strobo/u-battery/hardware/IMG_20130329_181824.jpg

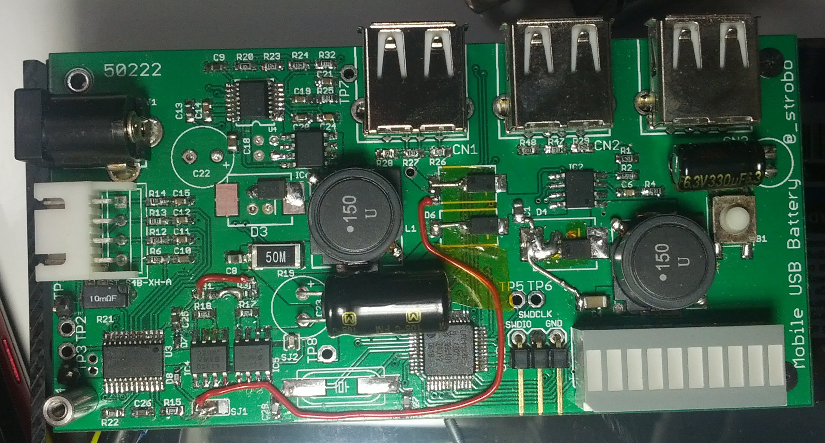
hardware/IMG_20130329_181824.jpg
