strobo/u-battery/hardware/assembly-guide.JPG

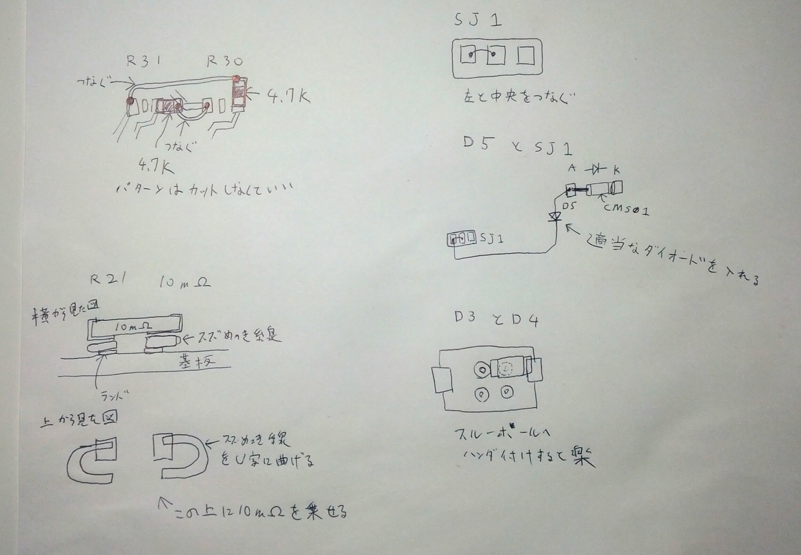
hardware/assembly-guide.JPG
