strobo/u-battery/README.md

u-Battery
===========

What's this?
------------
This is Mobile USB battery Unit.

This repo includes eagle .sch/.brd file and cortex-m0 source code.
