strobo/u-battery/hardware/brd.png

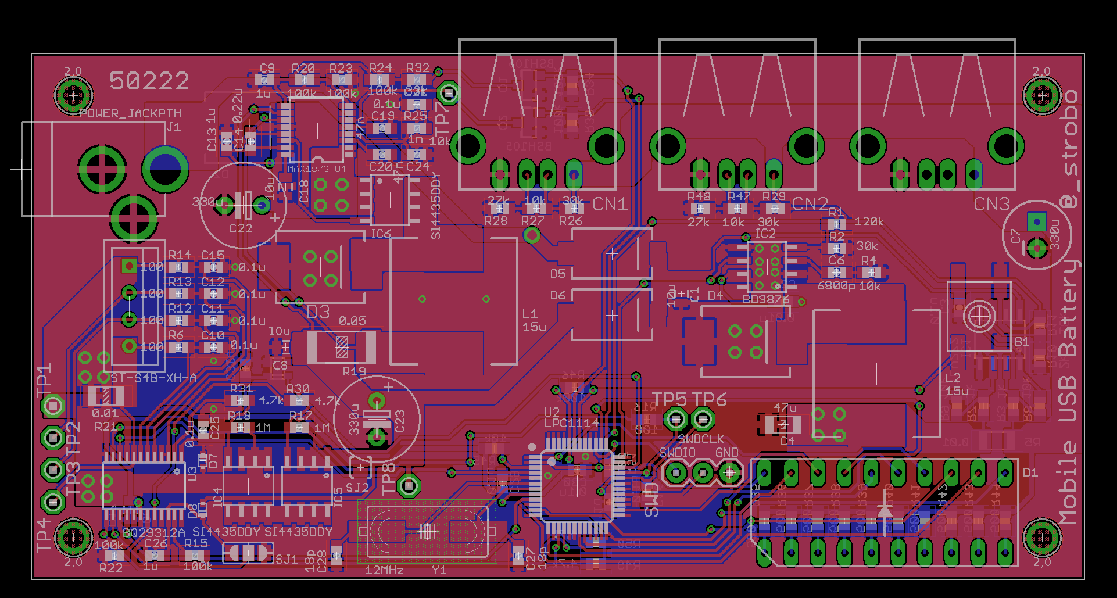
hardware/brd.png
