strobo/u-battery/hardware/brd_btn.png

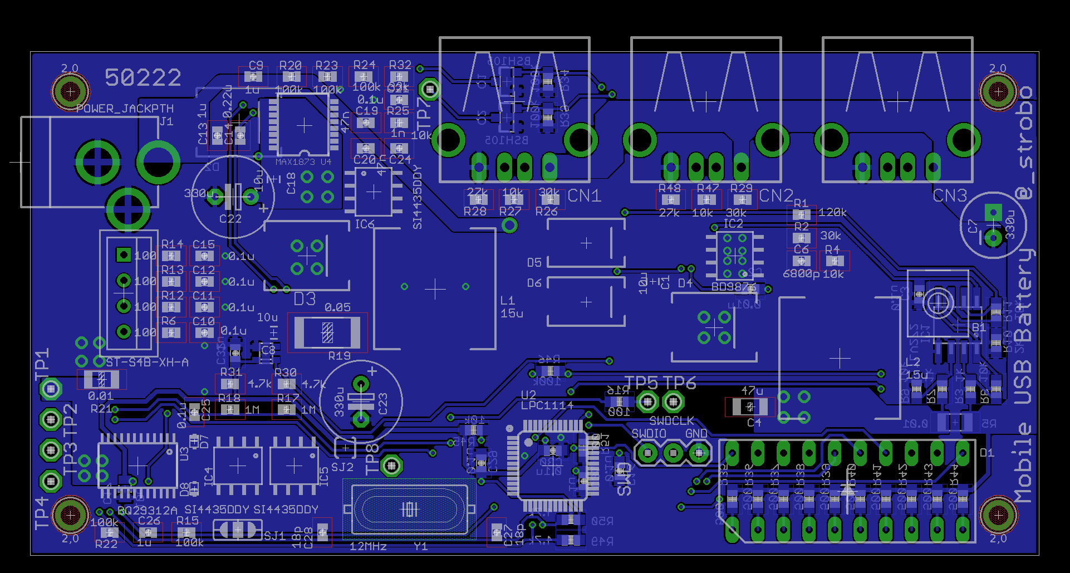
hardware/brd_btn.png
