strobo/u-battery/hardware/brd_t.png

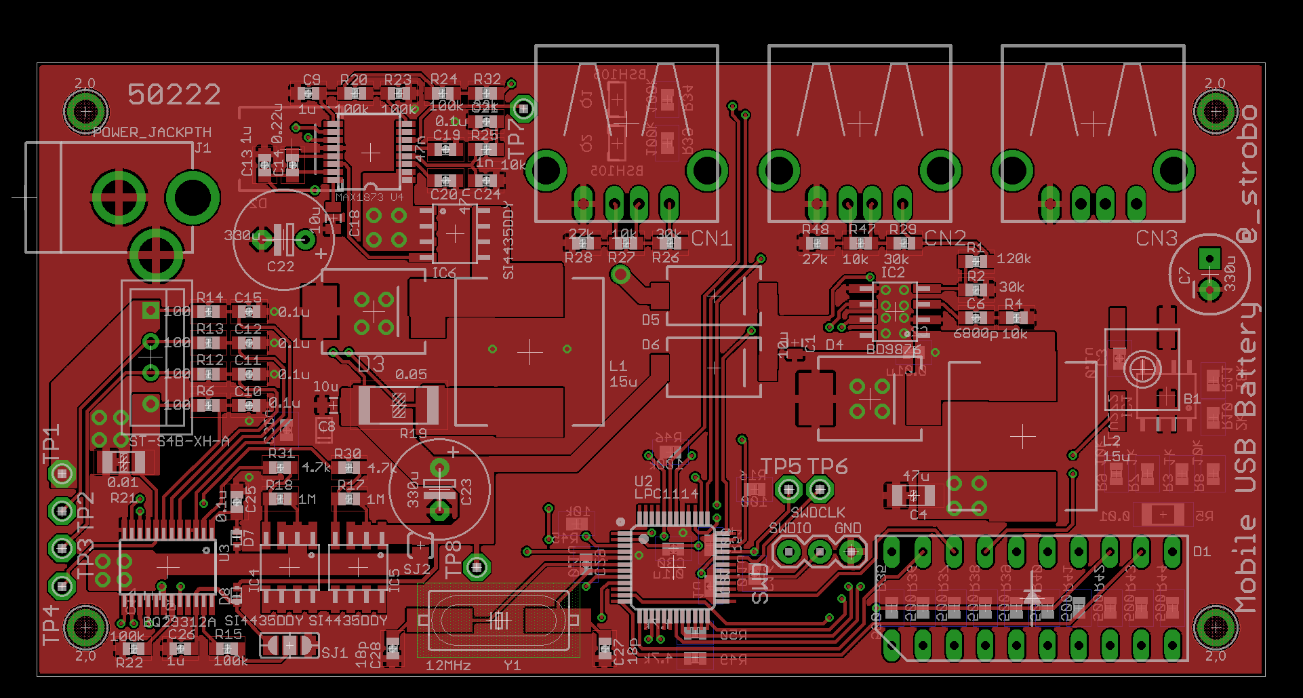
hardware/brd_t.png
