strobo/u-battery/hardware/IMG_20130329_230819.jpg

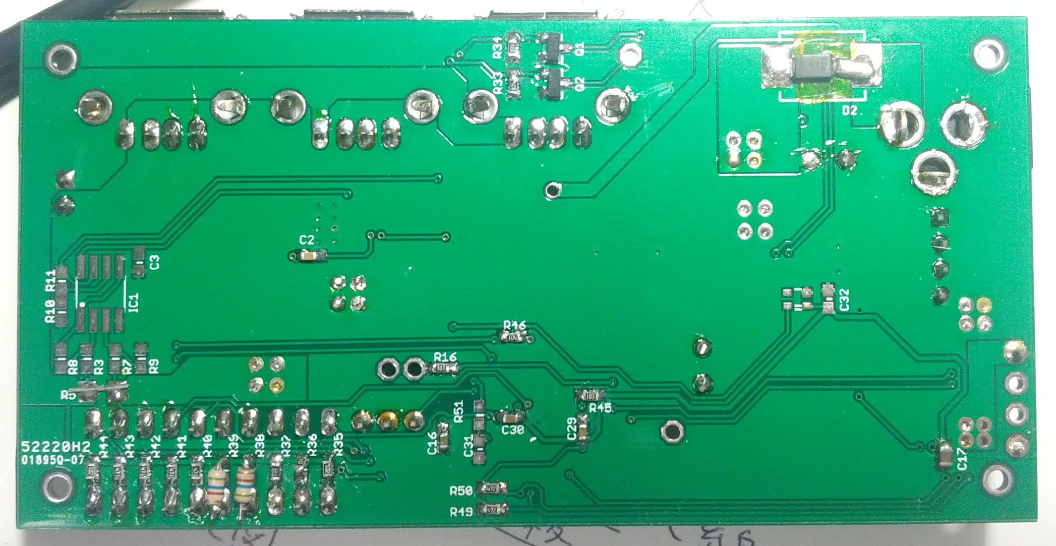
hardware/IMG_20130329_230819.jpg
