strobo/u-battery/hardware/sch.png

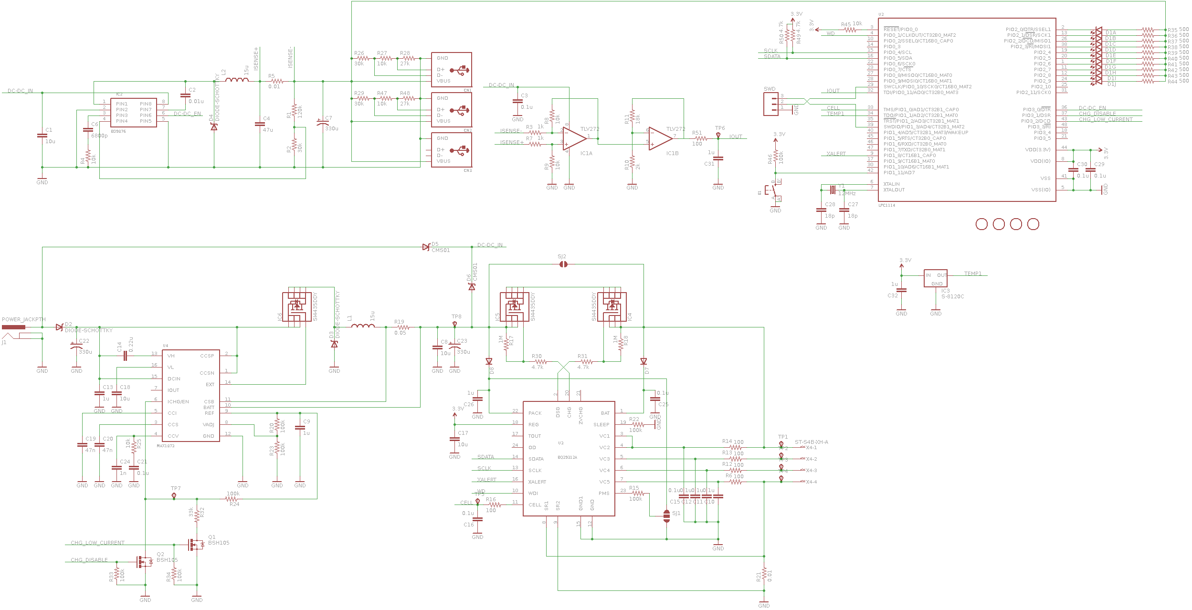
hardware/sch.png
