strobo/u-battery/hardware/mobileCharger.brd

## EAGLE design hardware/mobileCharger.brd (2012-09-06)

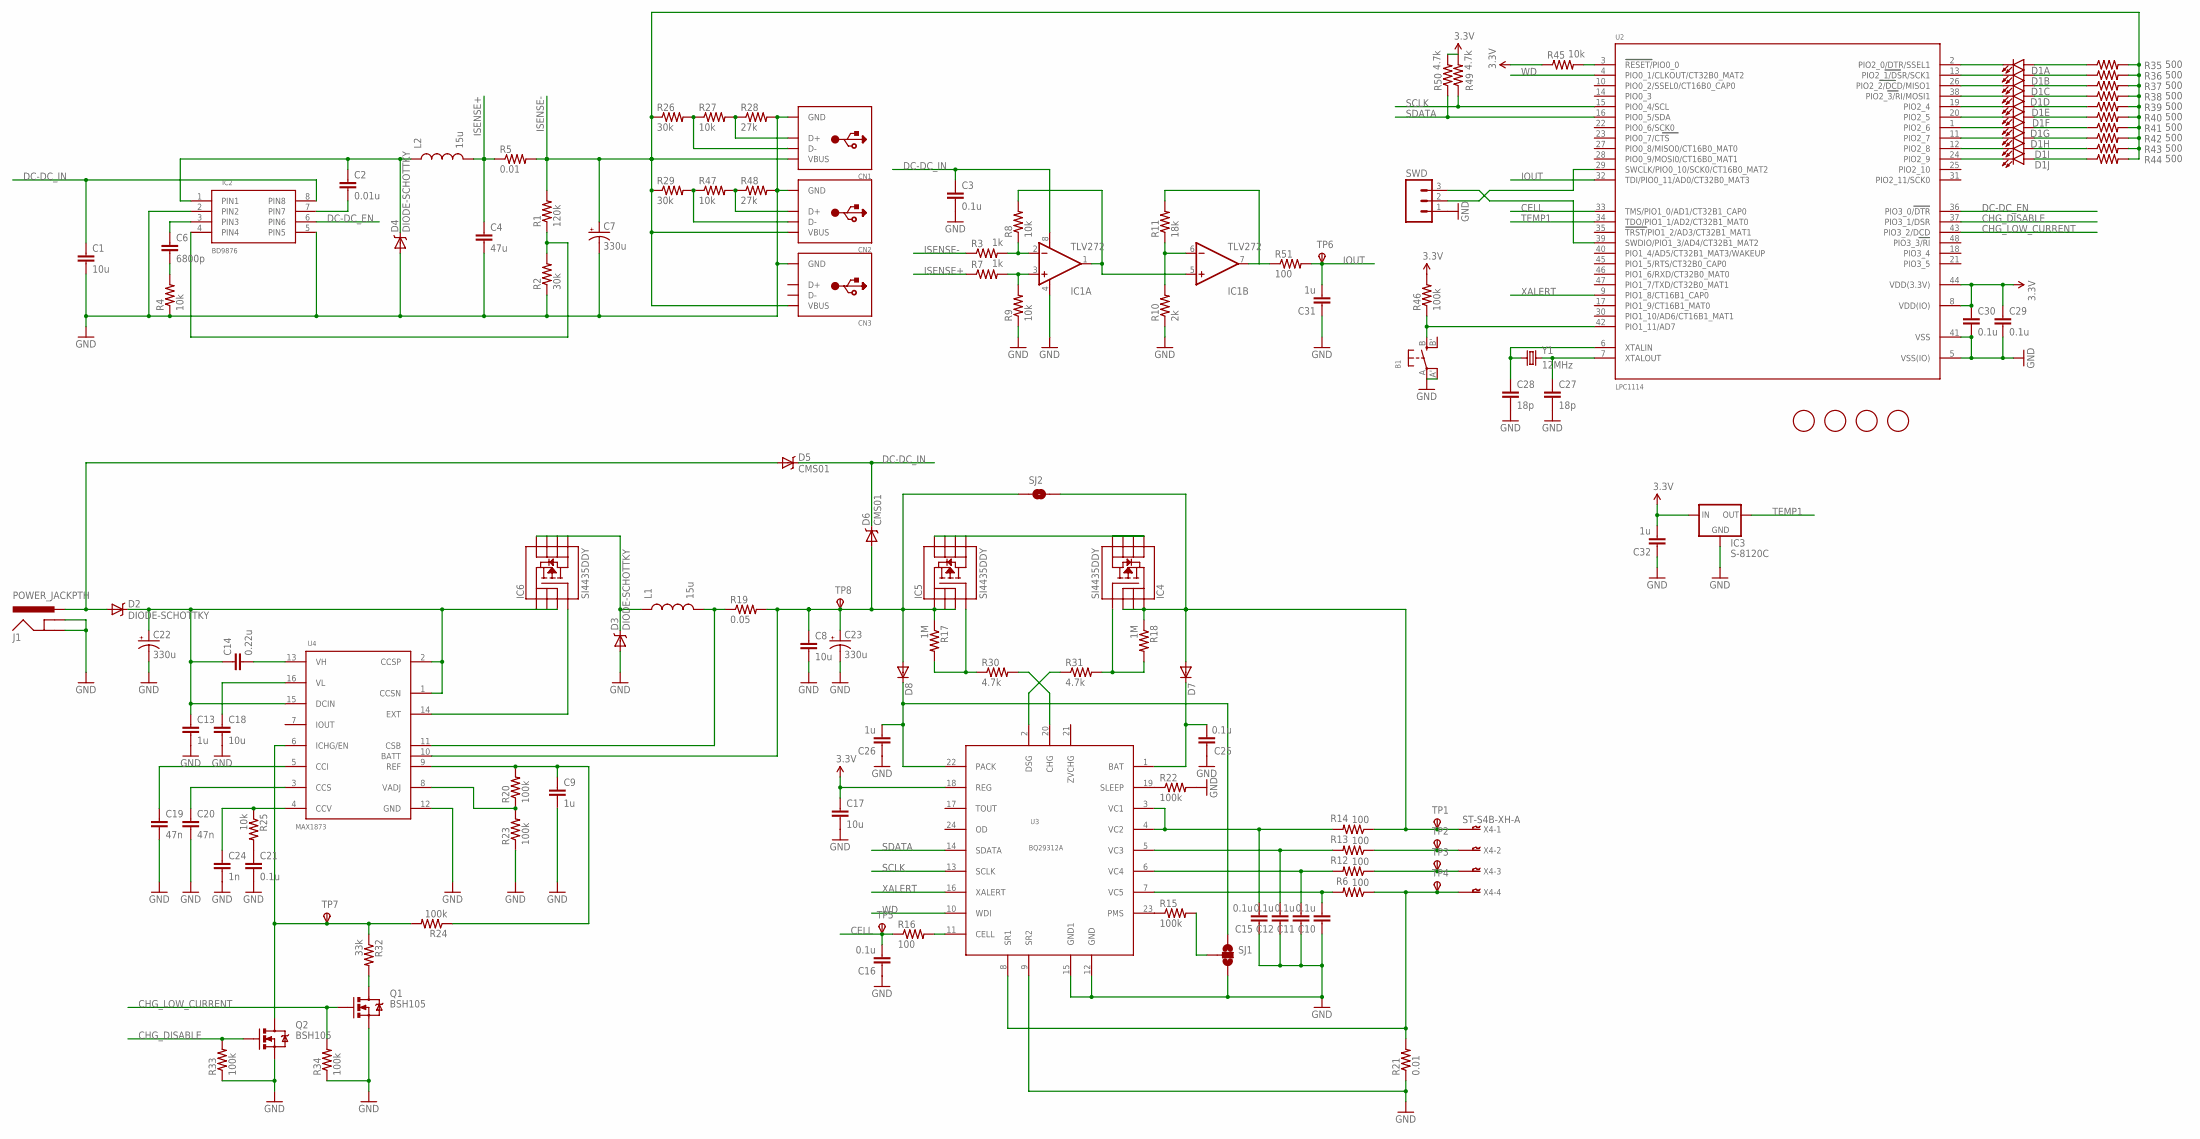
[picture p8: schematic mobileCharger.sch]

Parts:
B1: SWITCH_TACT_SMT; EVQ-Q2
C1, C8, C17, C18: 10u; 0805
C2: 0.01u; 0603-CAP
C3, C10, C11, C12, C15, C16, C21, C25, C29, C30: 0.1u; 0603-CAP
C4: 47u; 1206
C6: 6800p; 0603-CAP
C7: 330u; CPOL-RADIAL-100UF-25V
C9, C13, C26, C31, C32: 1u; 0603-CAP
C14: 0.22u; 0603-CAP
C19, C20: 47n; 0603-CAP
C22, C23: 330u; E3,5-8
C24: 1n; 0603-CAP
C27, C28: 18p; 0603-CAP
CN1, CN2, CN3: USB_TYPEAPTHFML; USB_HOST-PTH
D1: LED_BARGRAPH_10; LED_BARGAPH_10
D2, D3, D4: DIODE-SCHOTTKY; SOD-128
D5, D6: CMS01; M-FLAT
D7, D8: DIODESOD523; SOD523
IC1: TLV272; SO08
IC2: BD9876; SO08
IC3: S-8120C; SC-82AB
IC4, IC5, IC6: SI4435DDY; SO08
J1: POWER_JACKPTH; POWER_JACK_PTH
L1, L2: 15u; CDRH125
Q1, Q2: BSH105; SOT23-3
R1: 120k; 0603-RES
R2, R26, R29: 30k; 0603-RES
R3, R7: 1k; 0603-RES
R4, R8, R9, R25, R27, R45, R47: 10k; 0603-RES
R5, R21: 0.01; R1206
R6, R12, R13, R14, R16, R51: 100; 0603-RES
R10: 2k; 0603-RES
R11: 18k; 0603-RES
R15, R20, R22, R23, R24, R33, R34, R46: 100k; 0603-RES
R17, R18: 1M; 0603-RES
R19: 0.05; R2512
R28, R48: 27k; 0603-RES
R30, R31, R49, R50: 4.7k; 0603-RES
R32: 33k; 0603-RES
R35, R36, R37, R38, R39, R40, R41, R42, R43, R44: 500; 0603-RES
SJ1: SOLDERJUMPER_2WAYT; SJ_2
SJ2: SOLDERJUMPERNO; SJ_2S-NO
SWD: M03PTH; 1X03
TP1, TP2, TP3, TP4, TP5, TP6, TP7, TP8: TPSPAD1-13; P1-13
U2: LPC1114; LQFP48
U3: BQ29312A; TSSOP-24
U4: MAX1873; TSSOP16
U$1, U$2, U$3, U$7: MOUNTINGHOLE2.0; MOUNTINGHOLE_2.0_PLATED
X4: ST-S4B-XH-A; B4B-XH
Y1: 12MHz; HC49UP

Connections:
3.3V: C17.1, C29.1, C30.1, C32.2, IC3.P$1 (IN), R45.1, R46.2, R49.2, R50.2, U2.8 (VDD(IO)), U2.44 (VDD(3.3V)), U3.18 (REG)
CELL: C16.2, R16.1, TP5.TP, U2.33 (TMS/PIO1_0/AD1/CT32B1_CAP0)
CHG_DISABLE: Q2.1 (G), R33.2, U2.37 (PIO3_1/DSR)
CHG_LOW_CURRENT: Q1.1 (G), R34.2, U2.43 (PIO3_2/DCD)
DC-DC_EN: IC2.6 (PIN6), U2.36 (PIO3_0/DTR)
DC-DC_IN: C1.1, C3.1, D5.P$2 (C), D6.P$2 (C), IC1.8 (V+), IC2.8 (PIN8)
GND: B1.A, B1.A' (P1), C1.2, C3.2, C4.2, C7.2 (-), C8.2, C9.2, C10.1, C11.1, C12.1, C13.2, C15.1, C16.1, C17.2, C18.2, C19.2, C20.2, C21.2, C22.-, C23.-, C24.2, C25.1, C26.1, C27.2, C28.2, C29.2, C30.2, C31.1, C32.1, CN1.GND, CN2.GND, CN3.GND, D3.P$1 (A), D4.P$1 (A), IC1.4 (V-), IC2.2 (PIN2), IC2.5 (PIN5), IC3.P$2 (GND), J1.GND, J1.GNDBREAK, Q1.2 (S), Q2.2 (S), R2.1, R4.1, R9.1, R10.1, R21.1, R22.2, R23.1, R28.2, R33.1, R34.1, R48.2, SJ1.3, SWD.1, U2.5 (VSS(IO)), U2.41 (VSS), U3.9 (SR2), U3.12 (GND), U3.15 (GND1), U4.12 (GND)
IOUT: C31.2, R51.2, TP6.TP, U2.32 (TDI/PIO0_11/AD0/CT32B0_MAT3)
ISENSE+: C4.1, L2.2, R5.1, R7.1
ISENSE-: C7.1 (+), CN1.VBUS, CN2.VBUS, CN3.VBUS, R1.2, R3.1, R5.2, R26.1, R29.1, R35.2, R36.2, R37.2, R38.2, R39.2, R40.2, R41.2, R42.2, R43.2, R44.2
unnamed: C2.2, IC2.7 (PIN7)
unnamed: IC1.2 (-IN), R3.2, R8.1
unnamed: IC1.3 (+IN), R7.2, R9.2
unnamed: D1.1 (A), R35.1
unnamed: C2.1, D4.P$2 (C), IC2.1 (PIN1), L2.1
unnamed: IC1.6 (-IN), R10.2, R11.1
unnamed: C6.2, R4.2
unnamed: IC1.1 (OUT), IC1.5 (+IN), R8.2
unnamed: IC2.4 (PIN4), R1.1, R2.2
unnamed: C6.1, IC2.3 (PIN3)
unnamed: C9.1, R20.2, R24.1, U4.9 (REF)
unnamed: R15.2, SJ1.2
unnamed: C15.2, R14.2, U3.3 (VC1), U3.4 (VC2)
unnamed: D7.A, IC4.1 (S), IC4.2 (S), IC4.3 (S), R14.1, R18.1, SJ2.2, TP1.TP, X4.P$1
unnamed: R15.1, U3.23 (PMS)
unnamed: R16.2, U3.11 (CELL)
unnamed: C10.2, R6.2, U3.7 (VC5)
unnamed: IC4.5 (D), IC4.6 (D), IC4.7 (D), IC4.8 (D), IC5.5 (D), IC5.6 (D), IC5.7 (D), IC5.8 (D)
unnamed: C12.2, R13.2, U3.5 (VC3)
unnamed: C11.2, R12.2, U3.6 (VC4)
unnamed: R22.1, U3.19 (SLEEP)
unnamed: IC5.4 (G), R17.2, R30.1
unnamed: C26.2, D8.C, SJ1.1, U3.22 (PACK)
unnamed: IC4.4 (G), R18.2, R31.2
unnamed: C8.1, C23.+, D6.P$1 (A), D8.A, IC5.1 (S), IC5.2 (S), IC5.3 (S), R17.1, R19.2, SJ2.1, TP8.TP, U4.10 (BATT)
unnamed: R6.1, R21.2, TP4.TP, U3.8 (SR1), X4.P$4
unnamed: R20.1, R23.2, U4.8 (VADJ)
unnamed: L1.2, R19.1, U4.11 (CSB)
unnamed: Q1.3 (D), R32.2
unnamed: IC6.4 (G), U4.14 (EXT)
unnamed: Q2.3 (D), R24.2, R32.1, TP7.TP, U4.6 (ICHG/EN)
unnamed: D3.P$2 (C), IC6.5 (D), IC6.6 (D), IC6.7 (D), IC6.8 (D), L1.1
unnamed: C19.1, U4.5 (CCI)
unnamed: C20.1, U4.3 (CCS)
unnamed: C14.2, U4.13 (VH)
unnamed: C18.1, U4.16 (VL)
unnamed: C24.1, R25.1, U4.4 (CCV)
unnamed: C21.1, R25.2
unnamed: D2.P$1 (A), D5.P$1 (A), J1.PWR
unnamed: CN1.D+, R27.2, R28.1
unnamed: C13.1, C14.1, C22.+, D2.P$2 (C), IC6.1 (S), IC6.2 (S), IC6.3 (S), U4.1 (CCSN), U4.2 (CCSP), U4.15 (DCIN)
unnamed: R30.2, U3.20 (CHG)
unnamed: CN1.D-, R26.2, R27.1
unnamed: R31.1, U3.2 (DSG)
unnamed: SWD.2, U2.29 (SWCLK/PIO0_10/SCK0/CT16B0_MAT2)
unnamed: SWD.3, U2.39 (SWDIO/PIO1_3/AD4/CT32B1_MAT2)
unnamed: C25.2, D7.C, U3.1 (BAT)
unnamed: D1.2 (A), R36.1
unnamed: D1.3 (A), R37.1
unnamed: D1.4 (A), R38.1
unnamed: D1.5 (A), R39.1
unnamed: D1.6 (A), R40.1
unnamed: D1.7 (A), R41.1
unnamed: D1.9 (A), R43.1
unnamed: D1.8 (A), R42.1
unnamed: D1.10 (A), R44.1
unnamed: R45.2, U2.3 (RESET/PIO0_0)
unnamed: C28.1, U2.6 (XTALIN), Y1.1
unnamed: C27.1, U2.7 (XTALOUT), Y1.2
unnamed: D1.20 (C), U2.2 (PIO2_0/DTR/SSEL1)
unnamed: D1.19 (C), U2.13 (PIO2_1/DSR/SCK1)
unnamed: D1.18 (C), U2.26 (PIO2_2/DCD/MISO1)
unnamed: D1.17 (C), U2.38 (PIO2_3/RI/MOSI1)
unnamed: D1.16 (C), U2.19 (PIO2_4)
unnamed: D1.15 (C), U2.20 (PIO2_5)
unnamed: D1.14 (C), U2.1 (PIO2_6)
unnamed: D1.13 (C), U2.11 (PIO2_7)
unnamed: D1.12 (C), U2.12 (PIO2_8)
unnamed: D1.11 (C), U2.24 (PIO2_9)
unnamed: B1.B (S), R46.1, U2.42 (PIO1_11/AD7)
unnamed: R13.1, TP2.TP, X4.P$2
unnamed: R12.1, TP3.TP, X4.P$3
unnamed: CN2.D-, R29.2, R47.1
unnamed: CN2.D+, R47.2, R48.1
unnamed: IC1.7 (OUT), R11.2, R51.1
SCLK: R49.1, U2.15 (PIO0_4/SCL), U3.13 (SCLK)
SDATA: R50.1, U2.16 (PIO0_5/SDA), U3.14 (SDATA)
TEMP1: IC3.P$4 (OUT), U2.34 (TDO/PIO1_1/AD2/CT32B1_MAT0)
WD: U2.4 (PIO0_1/CLKOUT/CT32B0_MAT2), U3.10 (WDI)
XALERT: U2.9 (PIO1_8/CT16B1_CAP0), U3.16 (XALERT)

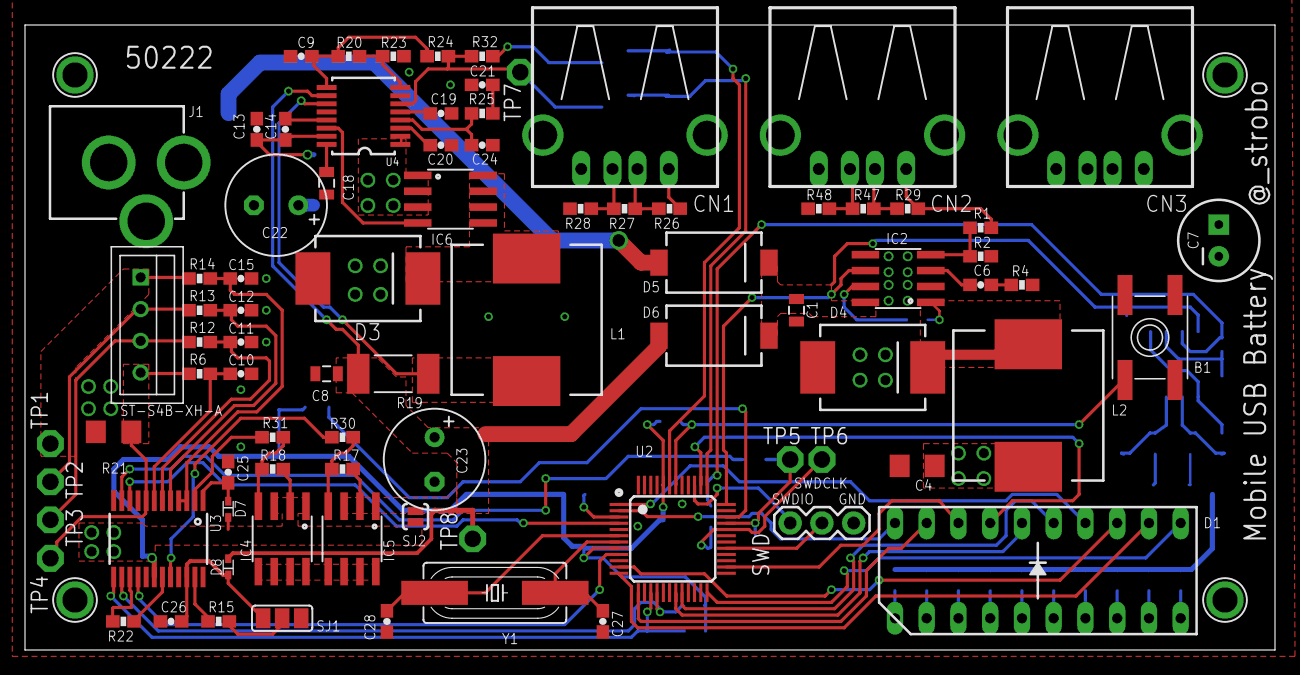
[picture p9: board mobileCharger.brd from above]

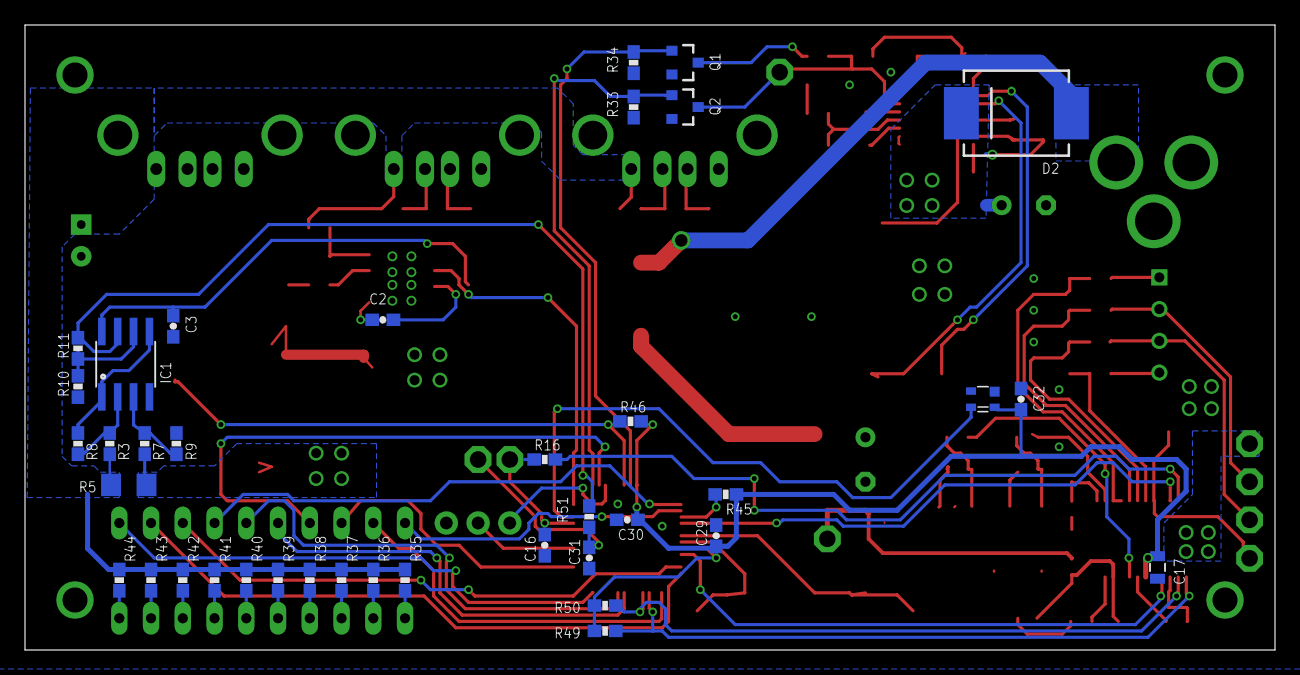
[picture p10: board mobileCharger.brd from below]

Board: 2 copper layers, 100.0 x 50.0 mm, 125 parts (38 on the bottom side), 90 nets.
