strobo/u-battery/(commit log)

2012-09-06 add README.md and eagle files
    [mobileCharger.GBL, mobileCharger.GBO, mobileCharger.GBP, mobileCharger.GBS, mobileCharger.GTL, mobileCharger.GTO, mobileCharger.GTP, mobileCharger.GTS]
2013-03-29 added assembly guide files
